MakeMagazinDE/BATTAMP/readme.md

changelog

bugfix PreAmp 2012-09-08 no1
Die Einkopplung des playback stereo Einganges auf die Basis des Aufholverstärkers T3 
bewirkt dass das playbacksignal mit zunehmendem "gain" leiser wird.
Jetzt geht sie auf den Emitter des Aufholverstärkers T3.

bugfix PreAmp 2012-09-08 no2
Die Lautstärke nahm deutlich zu mit zunehmendem "gain".
Um dies zu kompensieren, muß in diesem Bereich die Verstärkung des Aufholverstärkers (T3)
weiter abgesenkt werden. Dies erfordert einen höheren Emitterwiderstand, und deshalb auch einen
proportional höheren Kollektorwiderstand. Damit kann der passive Höhenregler nicht mehr
hinreichend niederohmig angesteuert werden und ein zusätzlicher Emitterfolger ist erforderlich.

2012-09-09
PreAmp: Sämtliche Bestückungspläne und BOM neu generiert
PowerAmp: Sämtliche Bestückungspläne und BOM neu generiert
