MakeMagazinDE/BATTAMP/PLATINE/pcb_power_2012_09_06_refs.png

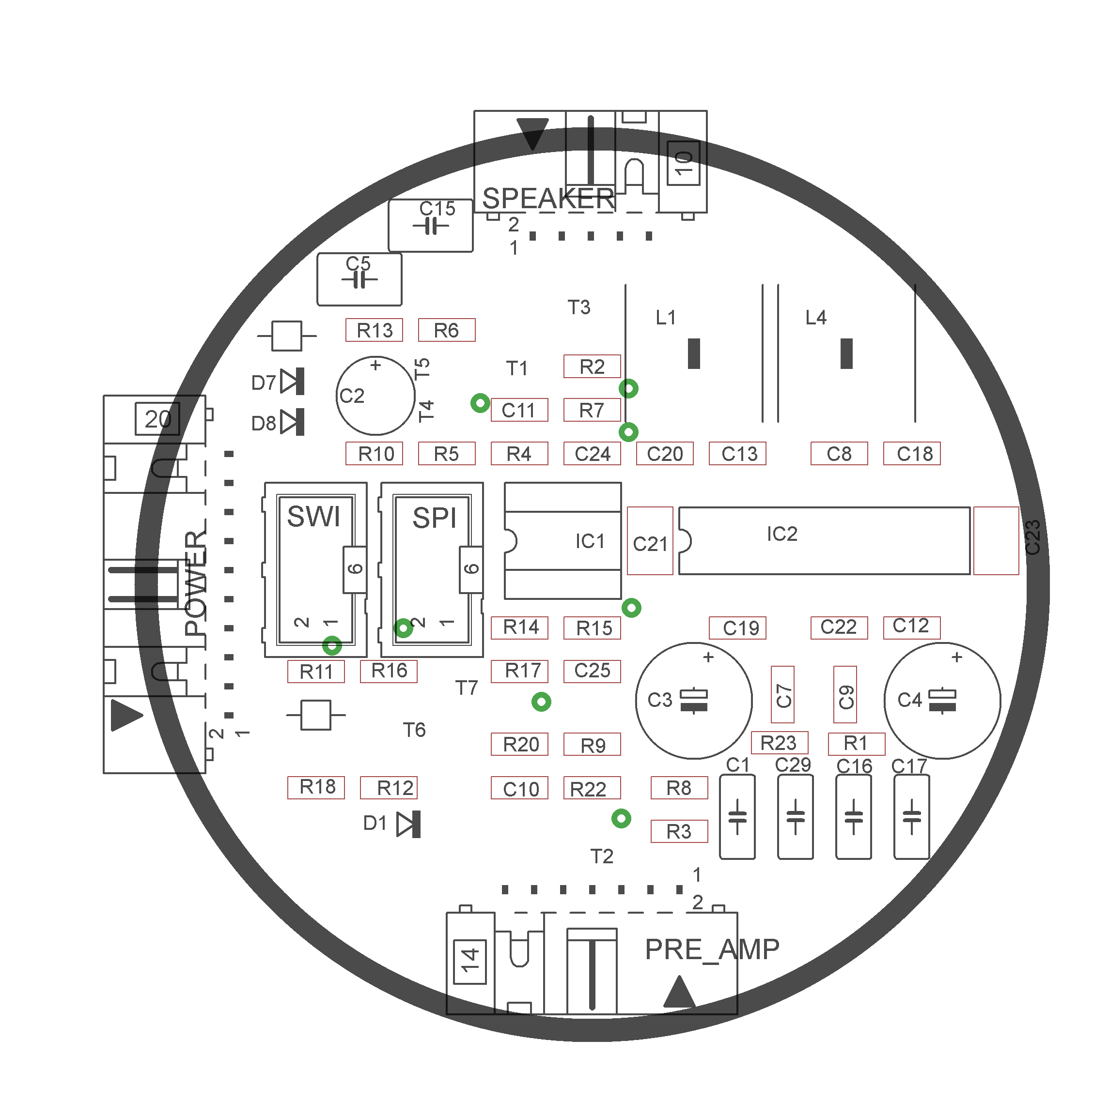
PLATINE/pcb_power_2012_09_06_refs.png
