MakeMagazinDE/BATTAMP/PLATINE/pcb_preamp_part2_2012_09_03_sch.png

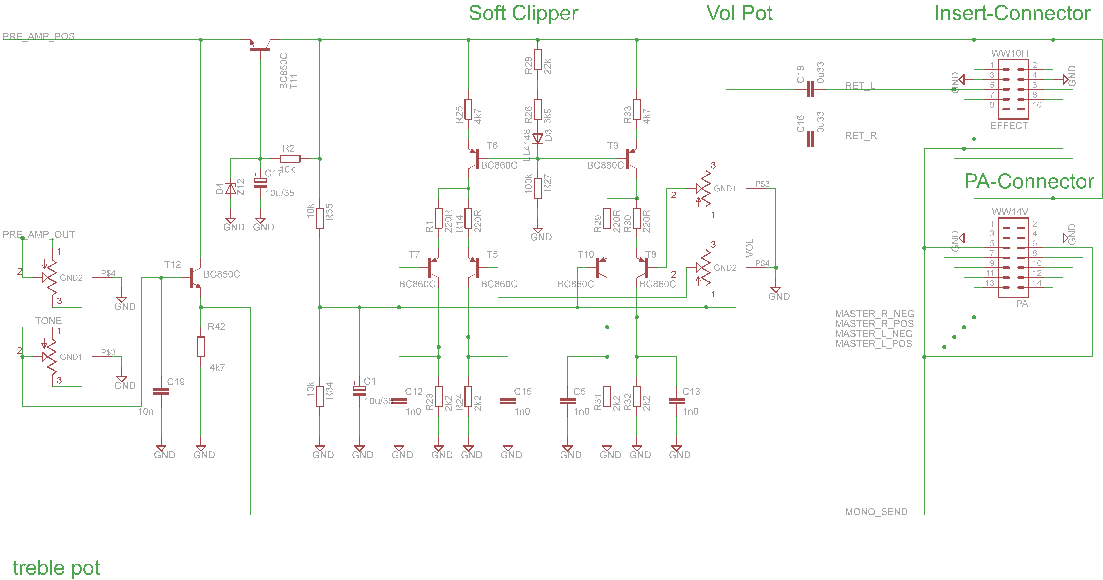
PLATINE/pcb_preamp_part2_2012_09_03_sch.png
